01HACKER01/Chaox-75-v2/keyboard-75.step

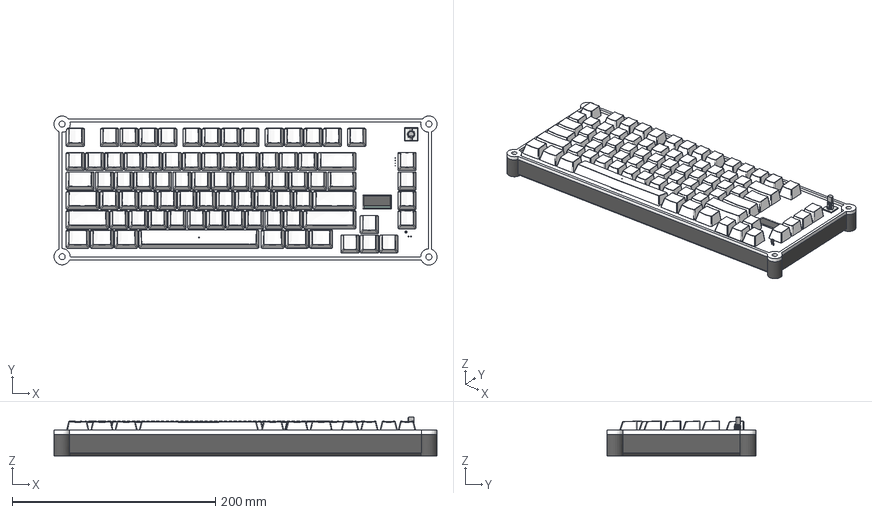
[picture p1: CAD file, 2026-11-03]
keyboard-75.step
376.5 x 146.6 x 38.0 mm
toppest plate
top plate
BOTTOM CASE
SW_Hotswap_Kailh_cp x 82
SW_Hotswap_Kailh_cp001 x 82
SW_Hotswap_Kailh_cp002 x 82
MX ÃÂÃÂ¡ ÃÂ°ÃÂ´ÃÂ¼ÃÂ¼ÃÂ¡ÃÂ¤_ÃÂ¨ÃÂ¹___ ÃÂ¡ÃÂ§1 x 81
MX ÃÂ¡ ÃÂ¡ÃÂ¥ÃÂ¨ÃÂ¢ÃÂ¨ÃÂ¬_ ÃÂ¡ÃÂ§ÃÂ¡Ã©Â¡Â§__ x 81
MXÃÂ¡ ÃÂÃÂ±LEDLEDLED x 81
MXÃÂ¡ ÃÂÃÂ±LEDLEDLED001 x 81
MXÃÂ¡ ÃÂÃÂ±LEDLEDLED002 x 81
MXÃÂ¡ ÃÂÃÂ±LEDLEDLED003 x 81
MXÃÂ¡ ÃÂÃÂ±LEDLEDLED004 x 81
MXÃÂÃÂ¡ ÃÂÃÂ¡ÃÂÃÂ¥ ÃÂµÃÂÃÂ²ÃÂ¿ ÃÂ¦ÃÂÃÂ¡ÃÂ2__ÃÂÃÂ¬ÃÂÃÂ_ ÃÂ¨ÃÂ¢2____ÃÂ¨ÃÂ¨_ x 81
ÃÂ«ÃÂ½ÃÂ__ÃÂ¬ÃÂ__ÃÂ¨ÃÂ¨_ x 81
ÃÂ«ÃÂ½ÃÂ__ÃÂ¬ÃÂ__ÃÂ¨ÃÂ¨_001 x 81
tab-key x 2
a-key x 68
Stabilizer_Cherry_MX_2u_cp x 3
Stabilizer_Cherry_MX_2u_cp001 x 3
Stabilizer_Cherry_MX_2u_cp002 x 3
Stabilizer_Cherry_MX_2u_cp003 x 3
Stabilizer_Cherry_MX_2u_cp004 x 3
R_0603_1608Metric x 9
L_0603_1608Metric x 3
C_0603_1608Metric x 13
right-shift-key2
USB_type_C_smd_12p.stp
USB_type_C_smd_12p.stp001
USB_type_C_smd_12p.stp002
USB_type_C_smd_12p.stp003
SOT-23 x 2
MX ÃÂÃÂ¡ ÃÂ°ÃÂ´ÃÂ¼ÃÂ¼ÃÂ¡ÃÂ¤_ÃÂ¨ÃÂ¹___ ÃÂ¡ÃÂ§017
MX ÃÂ¡ ÃÂ¡ÃÂ¥ÃÂ¨ÃÂ¢ÃÂ¨ÃÂ¬_ ÃÂ¡ÃÂ§ÃÂ¡Ã©Â¡Â§__017
MXÃÂ¡ ÃÂÃÂ±LEDLEDLED102
MXÃÂ¡ ÃÂÃÂ±LEDLEDLED103
MXÃÂ¡ ÃÂÃÂ±LEDLEDLED104
MXÃÂ¡ ÃÂÃÂ±LEDLEDLED105
MXÃÂ¡ ÃÂÃÂ±LEDLEDLED106
MXÃÂÃÂ¡ ÃÂÃÂ¡ÃÂÃÂ¥ ÃÂµÃÂÃÂ²ÃÂ¿ ÃÂ¦ÃÂÃÂ¡ÃÂ2__ÃÂÃÂ¬ÃÂÃÂ_ ÃÂ¨ÃÂ¢2____ÃÂ¨ÃÂ¨_017
ÃÂ«ÃÂ½ÃÂ__ÃÂ¬ÃÂ__ÃÂ¨ÃÂ¨_051
ÃÂ«ÃÂ½ÃÂ__ÃÂ¬ÃÂ__ÃÂ¨ÃÂ¨_052
enter-key x 2
PTS636Sx25SMTRLFS
PTS636Sx25SMTRLFS001
PTS636Sx25SMTRLFS002
PTS636Sx25SMTRLFS003
PTS636Sx25SMTRLFS004
SW_Slide_SPDT_Straight_CK_OS102011MS2Q
SW_Slide_SPDT_Straight_CK_OS102011MS2Q001
SW_Slide_SPDT_Straight_CK_OS102011MS2Q002
SW_Slide_SPDT_Straight_CK_OS102011MS2Q003
SW_Slide_SPDT_Straight_CK_OS102011MS2Q004
SW_Slide_SPDT_Straight_CK_OS102011MS2Q005
left-ctrl-key x 6
Stabilizer_Cherry_MX_3u_cp
Stabilizer_Cherry_MX_3u_cp001
Stabilizer_Cherry_MX_3u_cp002
Stabilizer_Cherry_MX_3u_cp003
Stabilizer_Cherry_MX_3u_cp004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
