01HACKER01/Chaox-75-v2/pcb/dongle.step

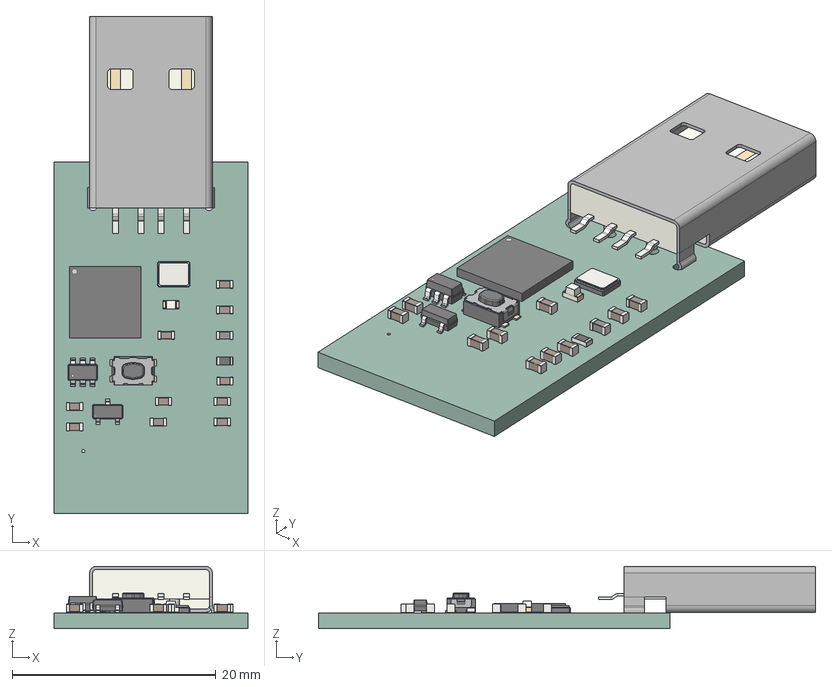
[picture p2: CAD file, 2026-10-25]
pcb/dongle.step
19.0 x 48.8 x 6.10 mm
SOT-23-6
C_0603_1608Metric x 10
SW_Push_1P1T_NO_CK_KMR2
R_0603_1608Metric
Crystal_SMD_3225-4Pin_3.2x2.5mm
SOT-23-3
USB_A_CNCTech_1001-011-01101_Horizontal
L_0603_1608Metric
Nordic_AQFN-73-1EP_7x7mm_P0.5mm
LED_0603_1608Metric
don4EA9_PCB
