01HACKER01/Chaox-75-v2/production/keyboard-75-top plate .step

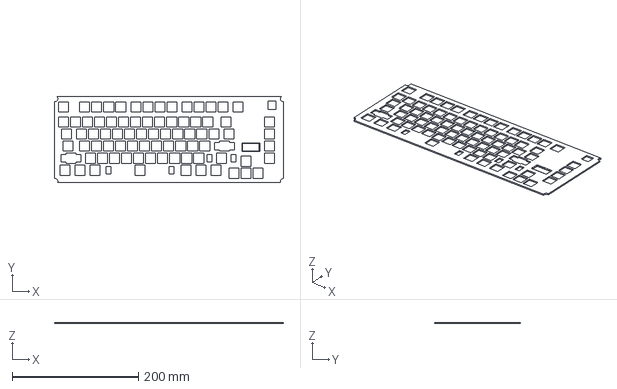
[picture p3: CAD file, 2026-10-25]
production/keyboard-75-top plate .step
362.5 x 135.4 x 2.00 mm
