01HACKER01/Chaox-75-v2/production/keyboard-75-toppest plate.step

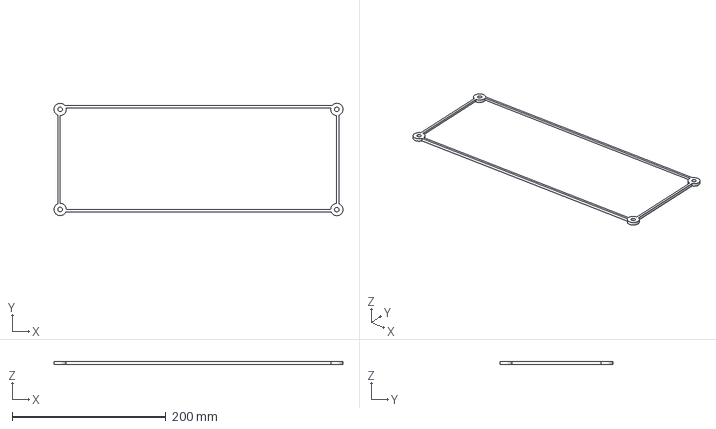
[picture p4: CAD file, 2026-10-25]
production/keyboard-75-toppest plate.step
376.5 x 146.6 x 4.00 mm
