01HACKER01/Chaox-75-v2/production/keyboard-75-BOTTOM CASE.step

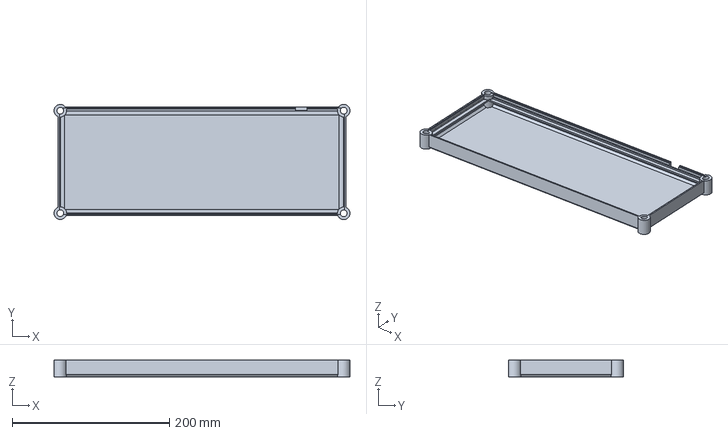
[picture p5: CAD file, 2026-10-25]
production/keyboard-75-BOTTOM CASE.step
376.5 x 146.6 x 21.2 mm
