01HACKER01/Chaox-75-v2/(list of files, cad)

Other CAD files:
pcb/CHAOX-75.step
cad/keyboard-75.FCStd
