01HACKER01/Chaox-75-v2/pcb/dongle.kicad_pcb

## KiCad design pcb/dongle.kicad_pcb (2026-10-25)

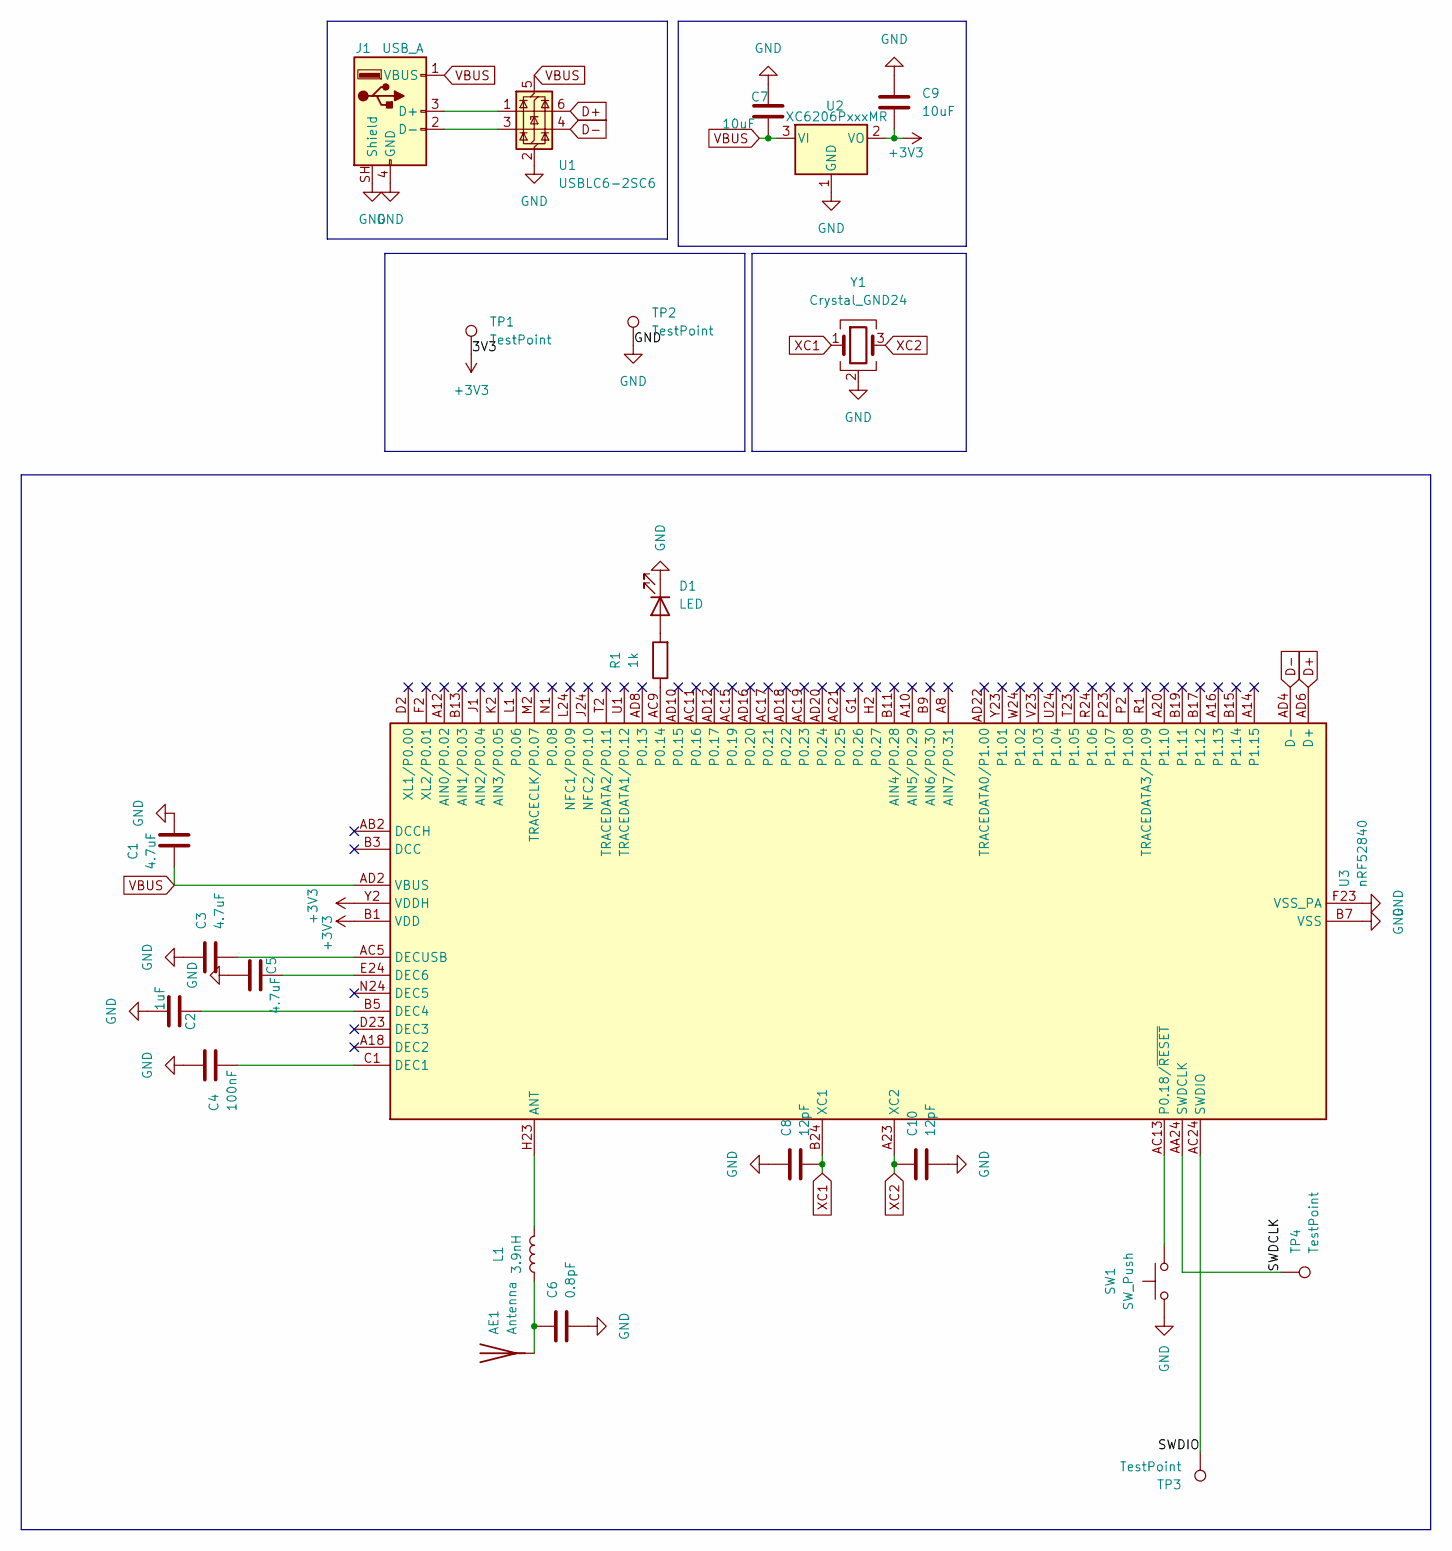
[picture p6: schematic dongle.kicad_sch]

Parts:
AE1: Antenna; Texas_SWRA117D_2.4GHz_Left
C1, C3, C5: 4.7uF; C_0603_1608Metric
C2: 1uF; C_0603_1608Metric
C4: 100nF; C_0603_1608Metric
C6: 0.8pF; C_0603_1608Metric
C7, C9: 10uF; C_0603_1608Metric
C8, C10: 12pF; C_0603_1608Metric
D1: LED; LED_0603_1608Metric
J1: USB_A; USB_A_Molex_67643_Horizontal
L1: 3.9nH; L_0603_1608Metric
R1: 1k; R_0603_1608Metric
SW1: SW_Push; SW_Push_1P1T_NO_CK_KMR2
TP1, TP2, TP3, TP4: TestPoint; TestPoint_Pad_D1.0mm
U1: USBLC6-2SC6; SOT-23-6
U2: XC6206PxxxMR; SOT-23-3
U3: nRF52840; Nordic_AQFN-73-1EP_7x7mm_P0.5mm
Y1: Crystal_GND24; Crystal_SMD_3225-4Pin_3.2x2.5mm

Connections:
+3V3: C9.2, TP1.1 (1_1), U2.2 (VO), U3.A22 (VDD), U3.AD14 (VDD), U3.AD23 (VDD), U3.B1 (VDD), U3.W1 (VDD), U3.Y2 (VDDH)
/SWDCLK: TP4.1 (1_1), U3.AA24 (SWDCLK)
/SWDIO: TP3.1 (1_1), U3.AC24 (SWDIO)
D+: U1.6 (I/O1), U3.AD6 (D+)
D-: U1.4 (I/O2), U3.AD4 (D-)
GND: AE1.2, C1.2, C2.1, C3.1, C4.1, C5.1, C6.2, C7.1, C8.1, C9.1, C10.2, D1.1 (K), J1.4 (GND), J1.SH (Shield), SW1.1, TP2.1 (1_1), U1.2 (GND), U2.1 (GND), U3.B7 (VSS), U3.EP (VSS), U3.F23 (VSS_PA), Y1.2 (G), Y1.4 (G)
unnamed: AE1.1 (A_1), C6.1, L1.1
unnamed: D1.2 (A), R1.2
unnamed: J1.3 (D+), U1.1 (I/O1)
unnamed: J1.2 (D-), U1.3 (I/O2)
unnamed: L1.2, U3.H23 (ANT)
unnamed: C4.2, U3.C1 (DEC1)
unnamed: C2.2, U3.B5 (DEC4)
unnamed: C5.2, U3.E24 (DEC6)
unnamed: C3.2, U3.AC5 (DECUSB)
unnamed: R1.1, U3.AC9 (P0.14)
unnamed: SW1.2, U3.AC13 (P0.18/~RESET)
VBUS: C1.1, C7.2, J1.1 (VBUS), U1.5 (VBUS), U2.3 (VI), U3.AD2 (VBUS)
XC1: C8.2, U3.B24 (XC1), Y1.1
XC2: C10.1, U3.A23 (XC2), Y1.3

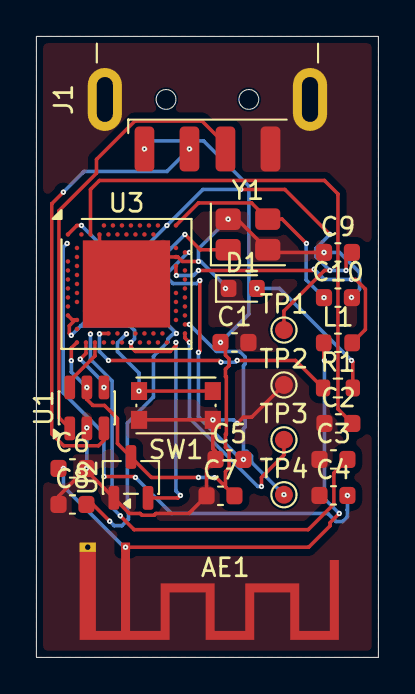
[picture p7: board dongle.kicad_pcb from above]

Board: 2 copper layers, 19.0 x 34.5 mm, 24 parts (0 on the bottom side), 20 nets.
