01HACKER01/Chaox-75-v2/production/Firmware Source code/keyboard/src/keymap.h

#ifndef CHAOX75_KEYMAP_H
#define CHAOX75_KEYMAP_H

#include <stdint.h>

#define MATRIX_ROWS 6
#define MATRIX_COLS 15

enum chaox75_keycode {
    KEY_NONE = 0,
    KEY_ESC,
    KEY_1, KEY_2, KEY_3, KEY_4, KEY_5, KEY_6, KEY_7, KEY_8, KEY_9, KEY_0,
    KEY_MINUS, KEY_EQUAL, KEY_BACKSPACE,
    KEY_TAB, KEY_Q, KEY_W, KEY_E, KEY_R, KEY_T, KEY_Y, KEY_U, KEY_I, KEY_O, KEY_P,
    KEY_LEFT_BRACKET, KEY_RIGHT_BRACKET, KEY_BACKSLASH,
    KEY_CAPS_LOCK, KEY_A, KEY_S, KEY_D, KEY_F, KEY_G, KEY_H, KEY_J, KEY_K, KEY_L,
    KEY_SEMICOLON, KEY_APOSTROPHE, KEY_ENTER,
    KEY_SHIFT, KEY_Z, KEY_X, KEY_C, KEY_V, KEY_B, KEY_N, KEY_M,
    KEY_COMMA, KEY_PERIOD, KEY_SLASH, KEY_RIGHT_SHIFT,
    KEY_CTRL, KEY_GUI, KEY_ALT, KEY_SPACE, KEY_FN,
    KEY_LEFT, KEY_DOWN, KEY_UP, KEY_RIGHT,
    KEY_HOME, KEY_END, KEY_PAGE_UP, KEY_PAGE_DOWN, KEY_DELETE, KEY_INSERT,
    KEY_F1, KEY_F2, KEY_F3, KEY_F4, KEY_F5, KEY_F6,
    KEY_F7, KEY_F8, KEY_F9, KEY_F10, KEY_F11, KEY_F12,
    KEY_MEDIA_PLAY_PAUSE, KEY_MEDIA_NEXT, KEY_MEDIA_PREVIOUS,
    KEY_MEDIA_MUTE, KEY_MEDIA_VOLUME_UP, KEY_MEDIA_VOLUME_DOWN
};

/*
 * Logical matrix layout. This is a starter layout, not a claim that switch
 * reference numbers map to these coordinates. Verify physical positions
 * against the PCB/netlist before flashing a board.
 */
static const uint8_t keymap[MATRIX_ROWS][MATRIX_COLS] = {
    { KEY_ESC, KEY_1, KEY_2, KEY_3, KEY_4, KEY_5, KEY_6, KEY_7, KEY_8, KEY_9, KEY_0, KEY_MINUS, KEY_EQUAL, KEY_BACKSPACE, KEY_NONE },
    { KEY_TAB, KEY_Q, KEY_W, KEY_E, KEY_R, KEY_T, KEY_Y, KEY_U, KEY_I, KEY_O, KEY_P, KEY_LEFT_BRACKET, KEY_RIGHT_BRACKET, KEY_BACKSLASH, KEY_NONE },
    { KEY_CAPS_LOCK, KEY_A, KEY_S, KEY_D, KEY_F, KEY_G, KEY_H, KEY_J, KEY_K, KEY_L, KEY_SEMICOLON, KEY_APOSTROPHE, KEY_ENTER, KEY_NONE, KEY_NONE },
    { KEY_SHIFT, KEY_Z, KEY_X, KEY_C, KEY_V, KEY_B, KEY_N, KEY_M, KEY_COMMA, KEY_PERIOD, KEY_SLASH, KEY_RIGHT_SHIFT, KEY_NONE, KEY_NONE, KEY_NONE },
    { KEY_CTRL, KEY_GUI, KEY_ALT, KEY_SPACE, KEY_FN, KEY_ALT, KEY_GUI, KEY_CTRL, KEY_NONE, KEY_NONE, KEY_NONE, KEY_NONE, KEY_NONE, KEY_NONE, KEY_NONE },
    { KEY_NONE, KEY_NONE, KEY_NONE, KEY_NONE, KEY_NONE, KEY_NONE, KEY_NONE, KEY_NONE, KEY_NONE, KEY_NONE, KEY_NONE, KEY_NONE, KEY_NONE, KEY_NONE, KEY_NONE },
};

#endif /* CHAOX75_KEYMAP_H */
